Aboodik/Power-monitor-system/Thor_Power_System 2/Thor_MCU.kicad_sch

## KiCad design Thor_Power_System 2/Thor_MCU.kicad_sch (2026-10-25)

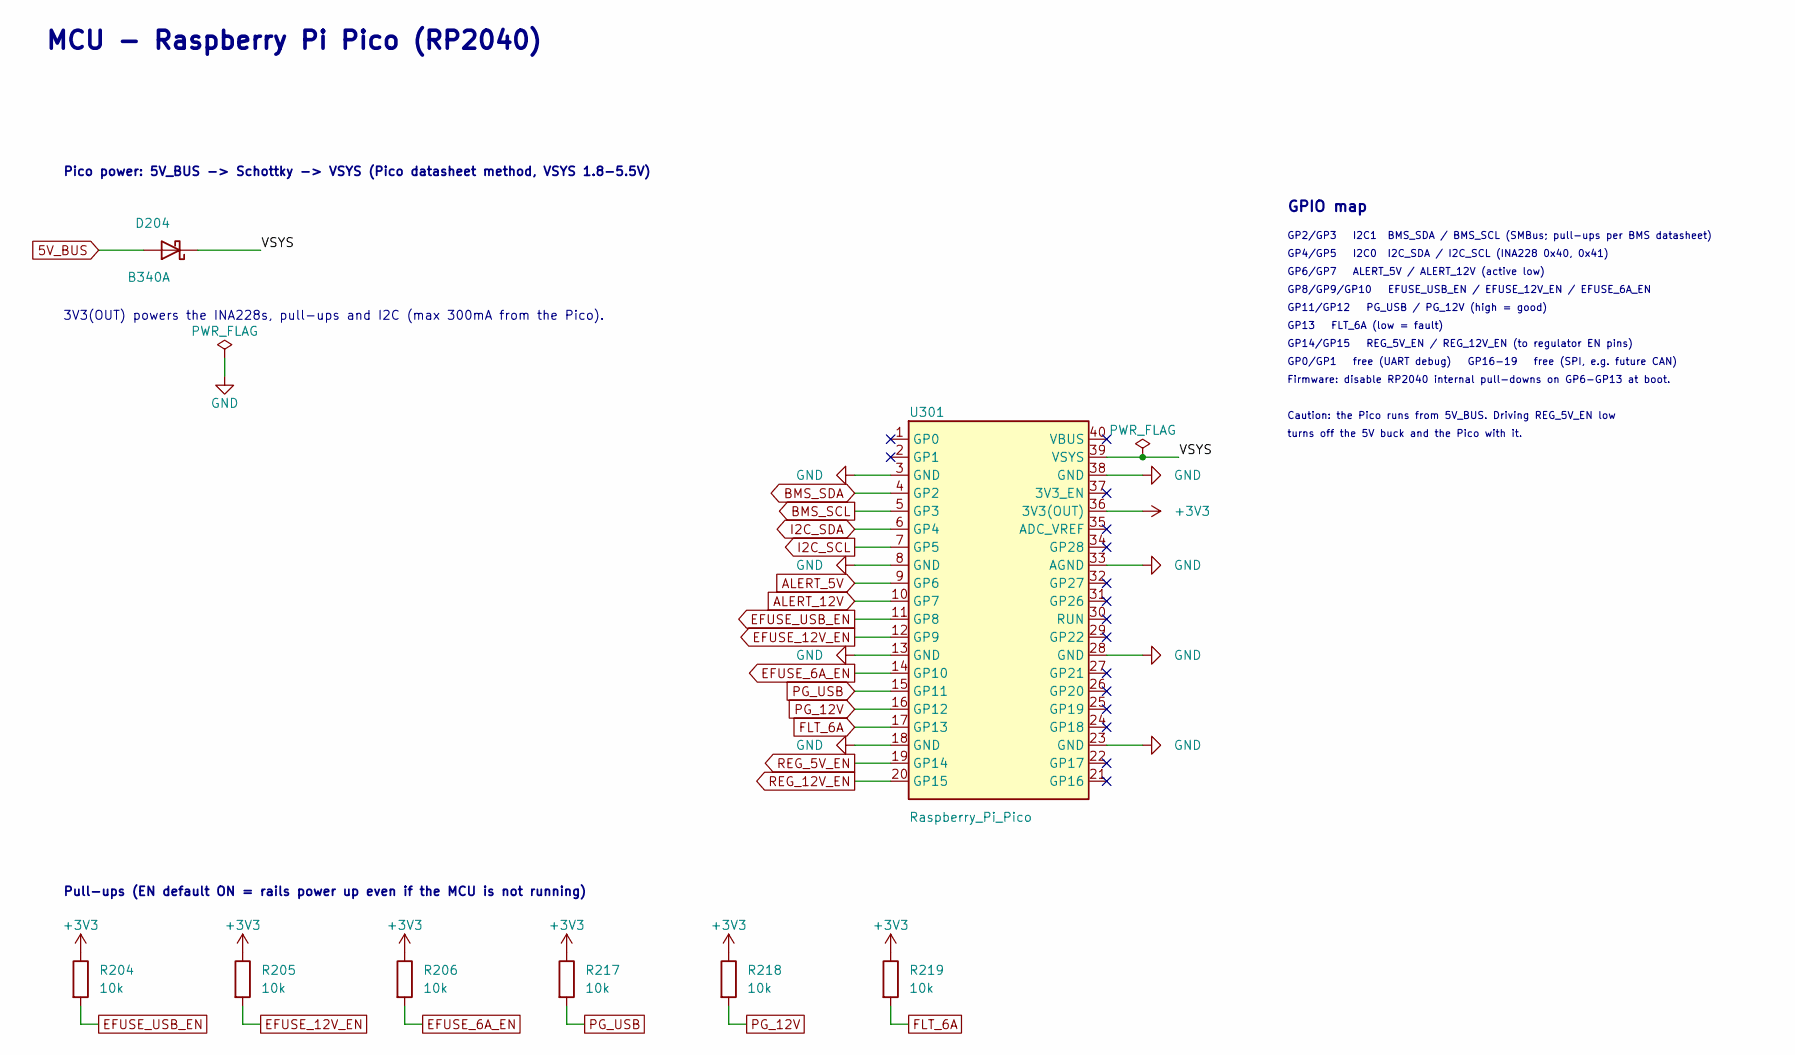
[picture p4: schematic Thor_MCU.kicad_sch]

Parts:
D204: B340A; D_SMA; MPN B340A-13-F
R204, R205, R206, R217, R218, R219: 10k; R_0603_1608Metric; MPN RC0603FR-0710KL
U301: Raspberry_Pi_Pico; RaspberryPi_Pico_TH; MPN SC0917 (Pico H) or SC0915

Connections:
5V_BUS: D204.2 (A)
+3V3: R204.1, R205.1, R206.1, R217.1, R218.1, R219.1, U301.36 (3V3(OUT))
ALERT_5V: U301.9 (GP6)
ALERT_12V: U301.10 (GP7)
BMS_SCL: U301.5 (GP3)
BMS_SDA: U301.4 (GP2)
EFUSE_6A_EN: R206.2, U301.14 (GP10)
EFUSE_12V_EN: R205.2, U301.12 (GP9)
EFUSE_USB_EN: R204.2, U301.11 (GP8)
FLT_6A: R219.2, U301.17 (GP13)
GND: U301.3 (GND), U301.8 (GND), U301.13 (GND), U301.18 (GND), U301.23 (GND), U301.28 (GND), U301.33 (AGND), U301.38 (GND)
I2C_SCL: U301.7 (GP5)
I2C_SDA: U301.6 (GP4)
PG_12V: R218.2, U301.16 (GP12)
PG_USB: R217.2, U301.15 (GP11)
REG_5V_EN: U301.19 (GP14)
REG_12V_EN: U301.20 (GP15)
VSYS: D204.1 (K), U301.39 (VSYS)

Notes on the sheet:
3V3(OUT) powers the INA228s, pull-ups and I2C (max 300mA from the Pico).
Pico power: 5V_BUS -> Schottky -> VSYS (Pico datasheet method, VSYS 1.8-5.5V)
Pull-ups (EN default ON = rails power up even if the MCU is not running)
GP0/GP1 free (UART debug) GP16-19 free (SPI, e.g. future CAN)
turns off the 5V buck and the Pico with it.
Caution: the Pico runs from 5V_BUS. Driving REG_5V_EN low
GP4/GP5 I2C0 I2C_SDA / I2C_SCL (INA228 0x40, 0x41)
GPIO map
GP6/GP7 ALERT_5V / ALERT_12V (active low)
Firmware: disable RP2040 internal pull-downs on GP6-GP13 at boot.
GP13 FLT_6A (low = fault)
GP2/GP3 I2C1 BMS_SDA / BMS_SCL (SMBus; pull-ups per BMS datasheet)
GP8/GP9/GP10 EFUSE_USB_EN / EFUSE_12V_EN / EFUSE_6A_EN
GP11/GP12 PG_USB / PG_12V (high = good)
GP14/GP15 REG_5V_EN / REG_12V_EN (to regulator EN pins)
MCU - Raspberry Pi Pico (RP2040)
