Aboodik/Power-monitor-system/Thor_Power_System 2/Thor_Protection.kicad_sch

## KiCad design Thor_Power_System 2/Thor_Protection.kicad_sch (2026-10-25)

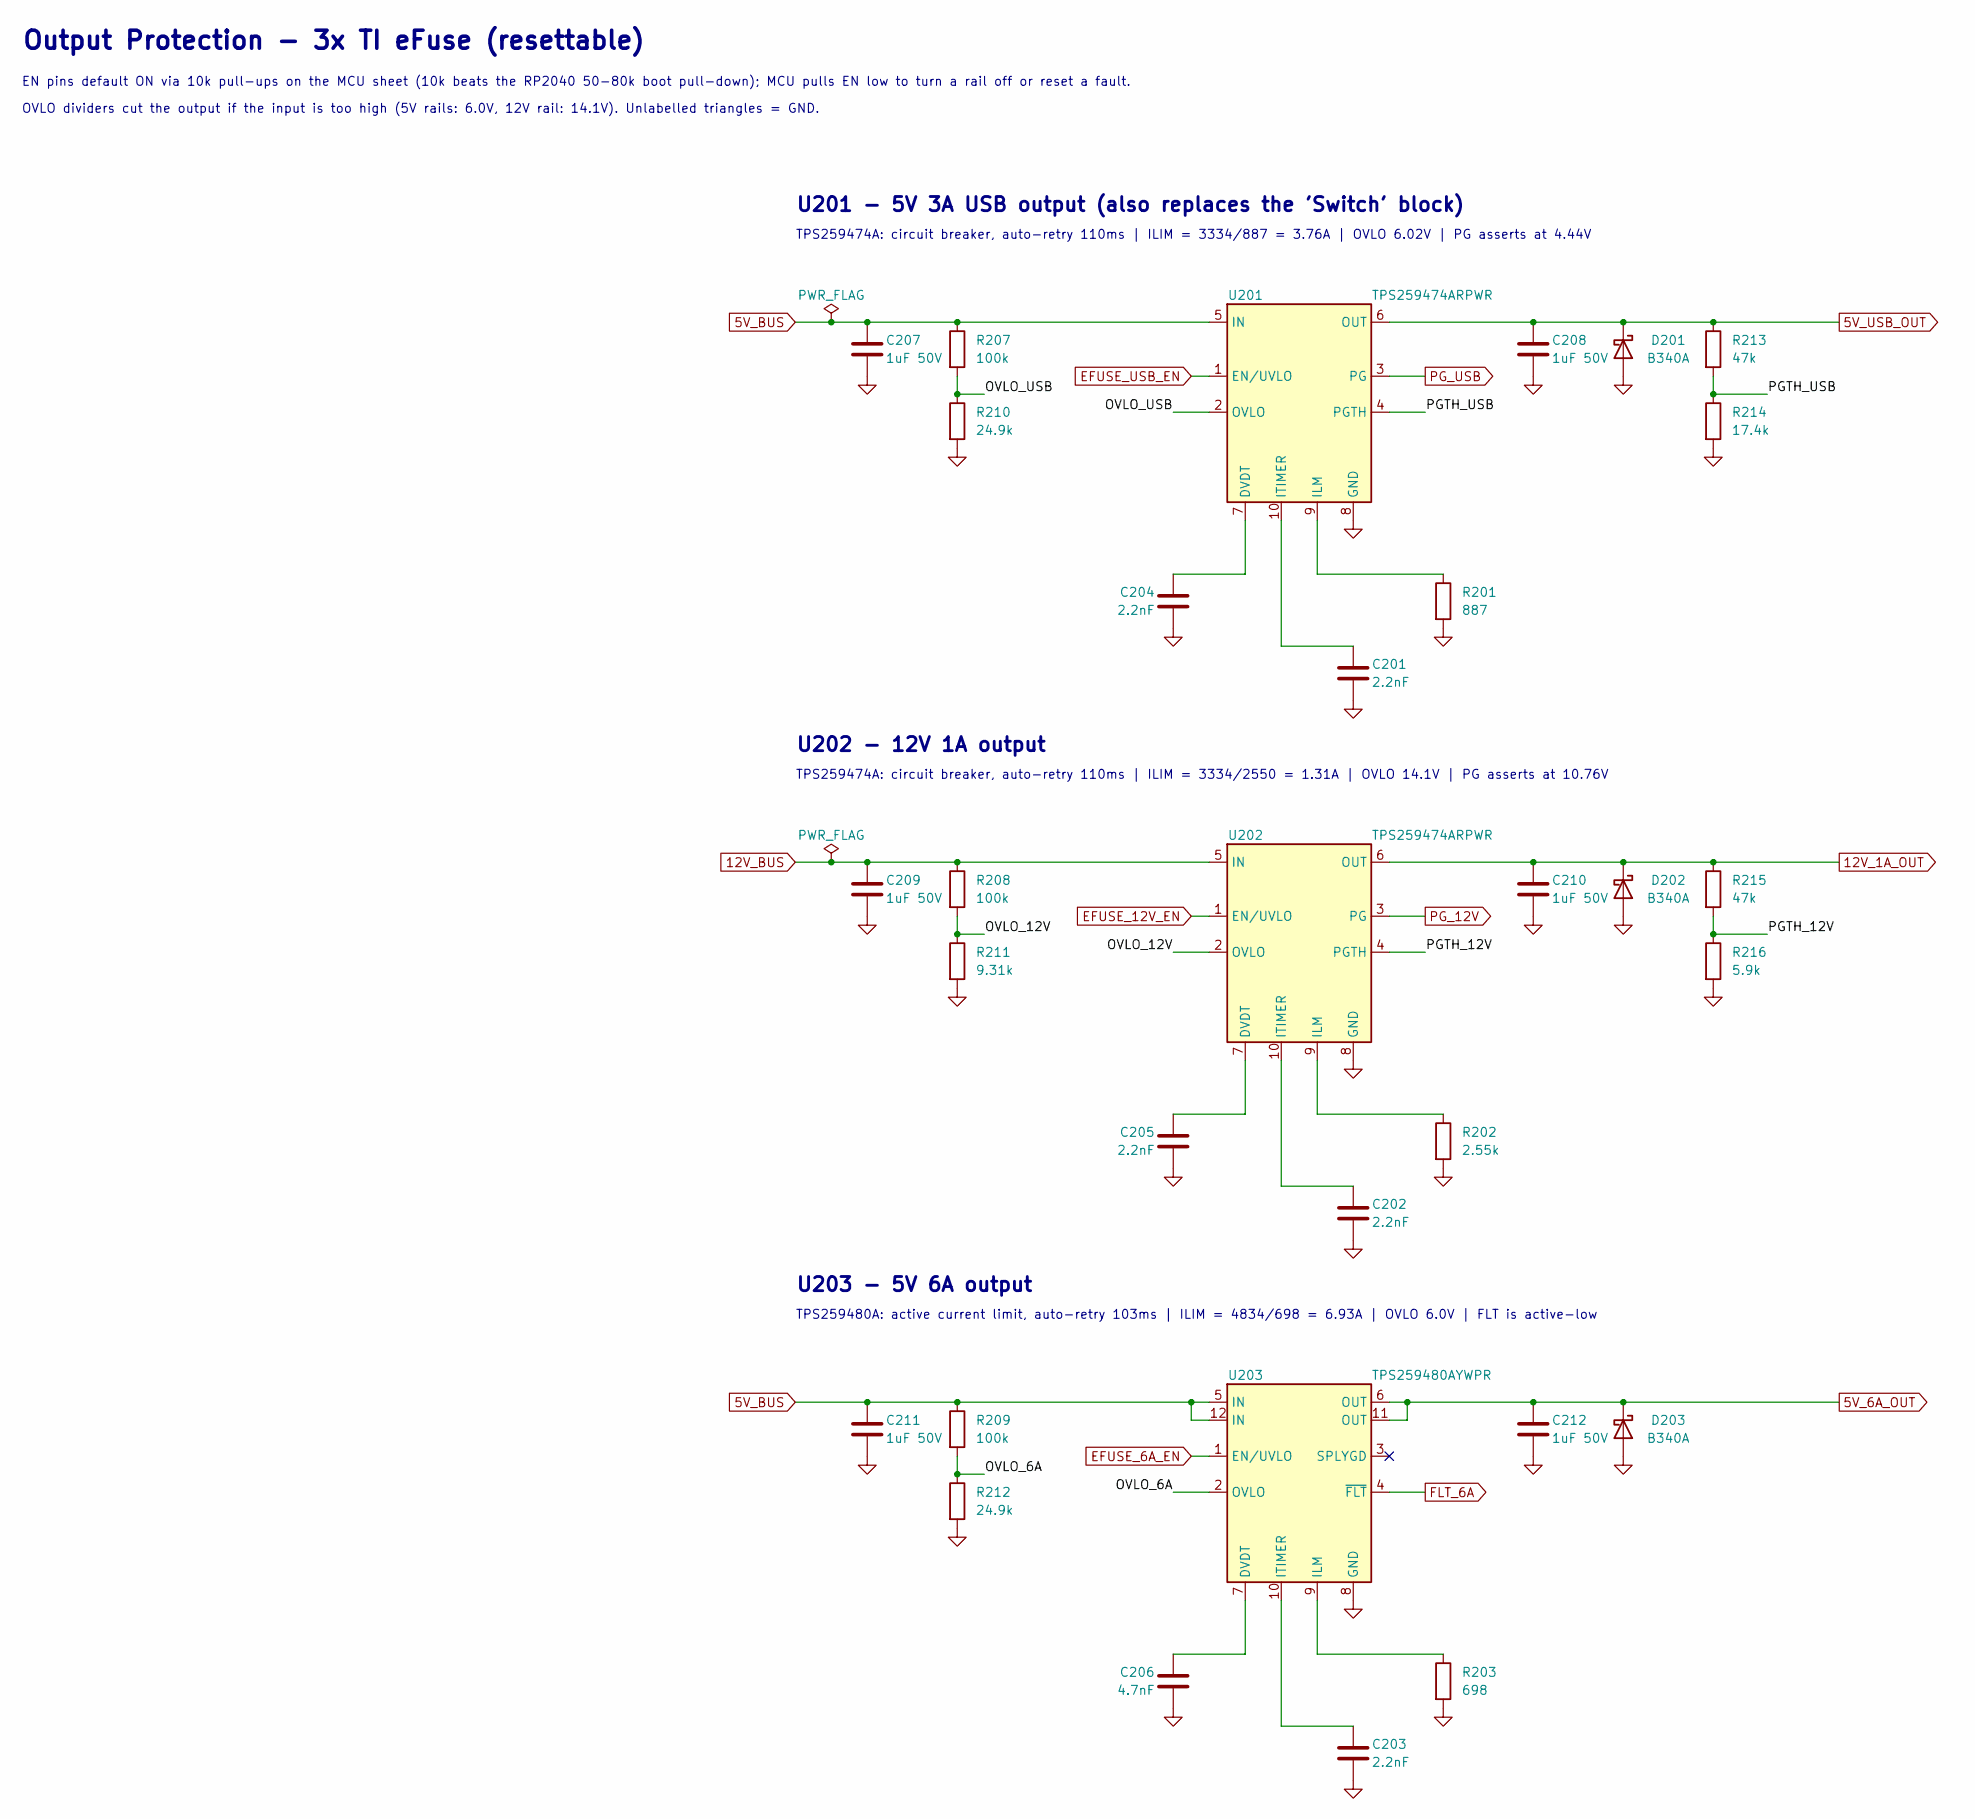
[picture p6: schematic Thor_Protection.kicad_sch]

Parts:
C201, C202, C203, C204, C205: 2.2nF; C_0603_1608Metric; MPN GRM1885C1H222JA01D
C206: 4.7nF; C_0603_1608Metric; MPN GRM1885C1H472JA01D
C207, C208, C209, C210, C211, C212: 1uF 50V; C_0805_2012Metric; MPN GRM21BR71H105KA12L
D201, D202, D203: B340A; D_SMA; MPN B340A-13-F
R201: 887; R_0603_1608Metric; MPN RC0603FR-07887RL
R202: 2.55k; R_0603_1608Metric; MPN RC0603FR-072K55L
R203: 698; R_0603_1608Metric; MPN RC0603FR-07698RL
R207, R208, R209: 100k; R_0603_1608Metric; MPN RC0603FR-07100KL
R210, R212: 24.9k; R_0603_1608Metric; MPN RC0603FR-0724K9L
R211: 9.31k; R_0603_1608Metric; MPN RC0603FR-079K31L
R213, R215: 47k; R_0603_1608Metric; MPN RC0603FR-0747KL
R214: 17.4k; R_0603_1608Metric; MPN RC0603FR-0717K4L
R216: 5.9k; R_0603_1608Metric; MPN RC0603FR-075K9L
U201, U202: TPS259474ARPWR; MPN TPS259474ARPWR
U203: TPS259480AYWPR; MPN TPS259480AYWPR

Connections:
5V_6A_OUT: C212.1, D203.1 (K), U203.6 (OUT), U203.11 (OUT)
5V_BUS: C207.1, C211.1, R207.1, R209.1, U201.5 (IN), U203.5 (IN), U203.12 (IN)
5V_USB_OUT: C208.1, D201.1 (K), R213.1, U201.6 (OUT)
12V_1A_OUT: C210.1, D202.1 (K), R215.1, U202.6 (OUT)
12V_BUS: C209.1, R208.1, U202.5 (IN)
EFUSE_6A_EN: U203.1 (EN/UVLO)
EFUSE_12V_EN: U202.1 (EN/UVLO)
EFUSE_USB_EN: U201.1 (EN/UVLO)
FLT_6A: U203.4 (~FLT)
GND: C201.2, C202.2, C203.2, C204.2, C205.2, C206.2, C207.2, C208.2, C209.2, C210.2, C211.2, C212.2, D201.2 (A), D202.2 (A), D203.2 (A), R201.2, R202.2, R203.2, R210.2, R211.2, R212.2, R214.2, R216.2, U201.8 (GND), U202.8 (GND), U203.8 (GND)
unnamed: C201.1, U201.10 (ITIMER)
unnamed: C202.1, U202.10 (ITIMER)
unnamed: C203.1, U203.10 (ITIMER)
unnamed: C204.1, U201.7 (DVDT)
unnamed: C205.1, U202.7 (DVDT)
unnamed: C206.1, U203.7 (DVDT)
unnamed: R201.1, U201.9 (ILM)
unnamed: R202.1, U202.9 (ILM)
unnamed: R203.1, U203.9 (ILM)
OVLO_6A: R209.2, R212.1, U203.2 (OVLO)
OVLO_12V: R208.2, R211.1, U202.2 (OVLO)
OVLO_USB: R207.2, R210.1, U201.2 (OVLO)
PGTH_12V: R215.2, R216.1, U202.4 (PGTH)
PGTH_USB: R213.2, R214.1, U201.4 (PGTH)
PG_12V: U202.3 (PG)
PG_USB: U201.3 (PG)

Notes on the sheet:
U201 - 5V 3A USB output (also replaces the 'Switch' block)
OVLO dividers cut the output if the input is too high (5V rails: 6.0V, 12V rail: 14.1V). Unlabelled triangles = GND.
U202 - 12V 1A output
Output Protection - 3x TI eFuse (resettable)
TPS259480A: active current limit, auto-retry 103ms | ILIM = 4834/698 = 6.93A | OVLO 6.0V | FLT is active-low
EN pins default ON via 10k pull-ups on the MCU sheet (10k beats the RP2040 50-80k boot pull-down); MCU pulls EN low to turn a rail off or reset a fault.
TPS259474A: circuit breaker, auto-retry 110ms | ILIM = 3334/2550 = 1.31A | OVLO 14.1V | PG asserts at 10.76V
U203 - 5V 6A output
TPS259474A: circuit breaker, auto-retry 110ms | ILIM = 3334/887 = 3.76A | OVLO 6.02V | PG asserts at 4.44V
